TrevorKayongaJoel/AWS/CAD MODELS/prototype panel seperators/gateway acrilic.dxf

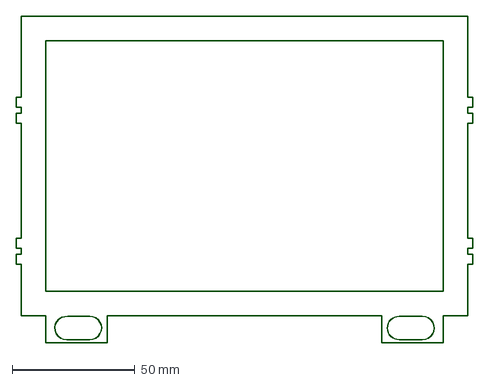
[picture p1: CAD file, 2026-03-18]
CAD MODELS/prototype panel seperators/gateway acrilic.dxf
186.0 x 133.0 mm
