TrevorKayongaJoel/AWS/CAD MODELS/prototype panel seperators/seperator.dxf

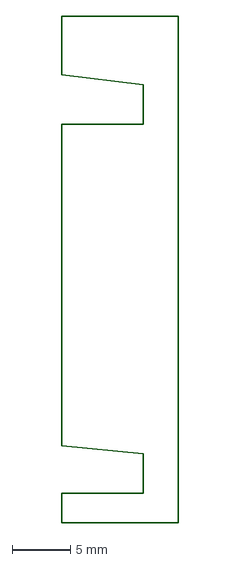
[picture p2: CAD file, 2026-03-18]
CAD MODELS/prototype panel seperators/seperator.dxf
10.0 x 43.4 mm
