TrevorKayongaJoel/AWS/CAD MODELS/prototype panel seperators/power acrilic.dxf

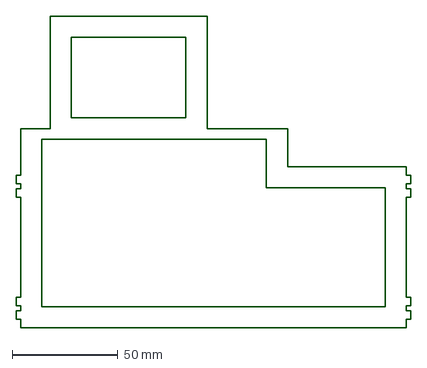
[picture p3: CAD file, 2026-03-18]
CAD MODELS/prototype panel seperators/power acrilic.dxf
186.0 x 147.0 mm
