TrevorKayongaJoel/AWS/(list of files, cad)

Other CAD files:
CAD MODELS/prototype panel seperators/seperator AWS.dwg
