TrevorKayongaJoel/AWS/CAD MODELS/prototype panel seperators/seperator AWS-Layout1.pdf

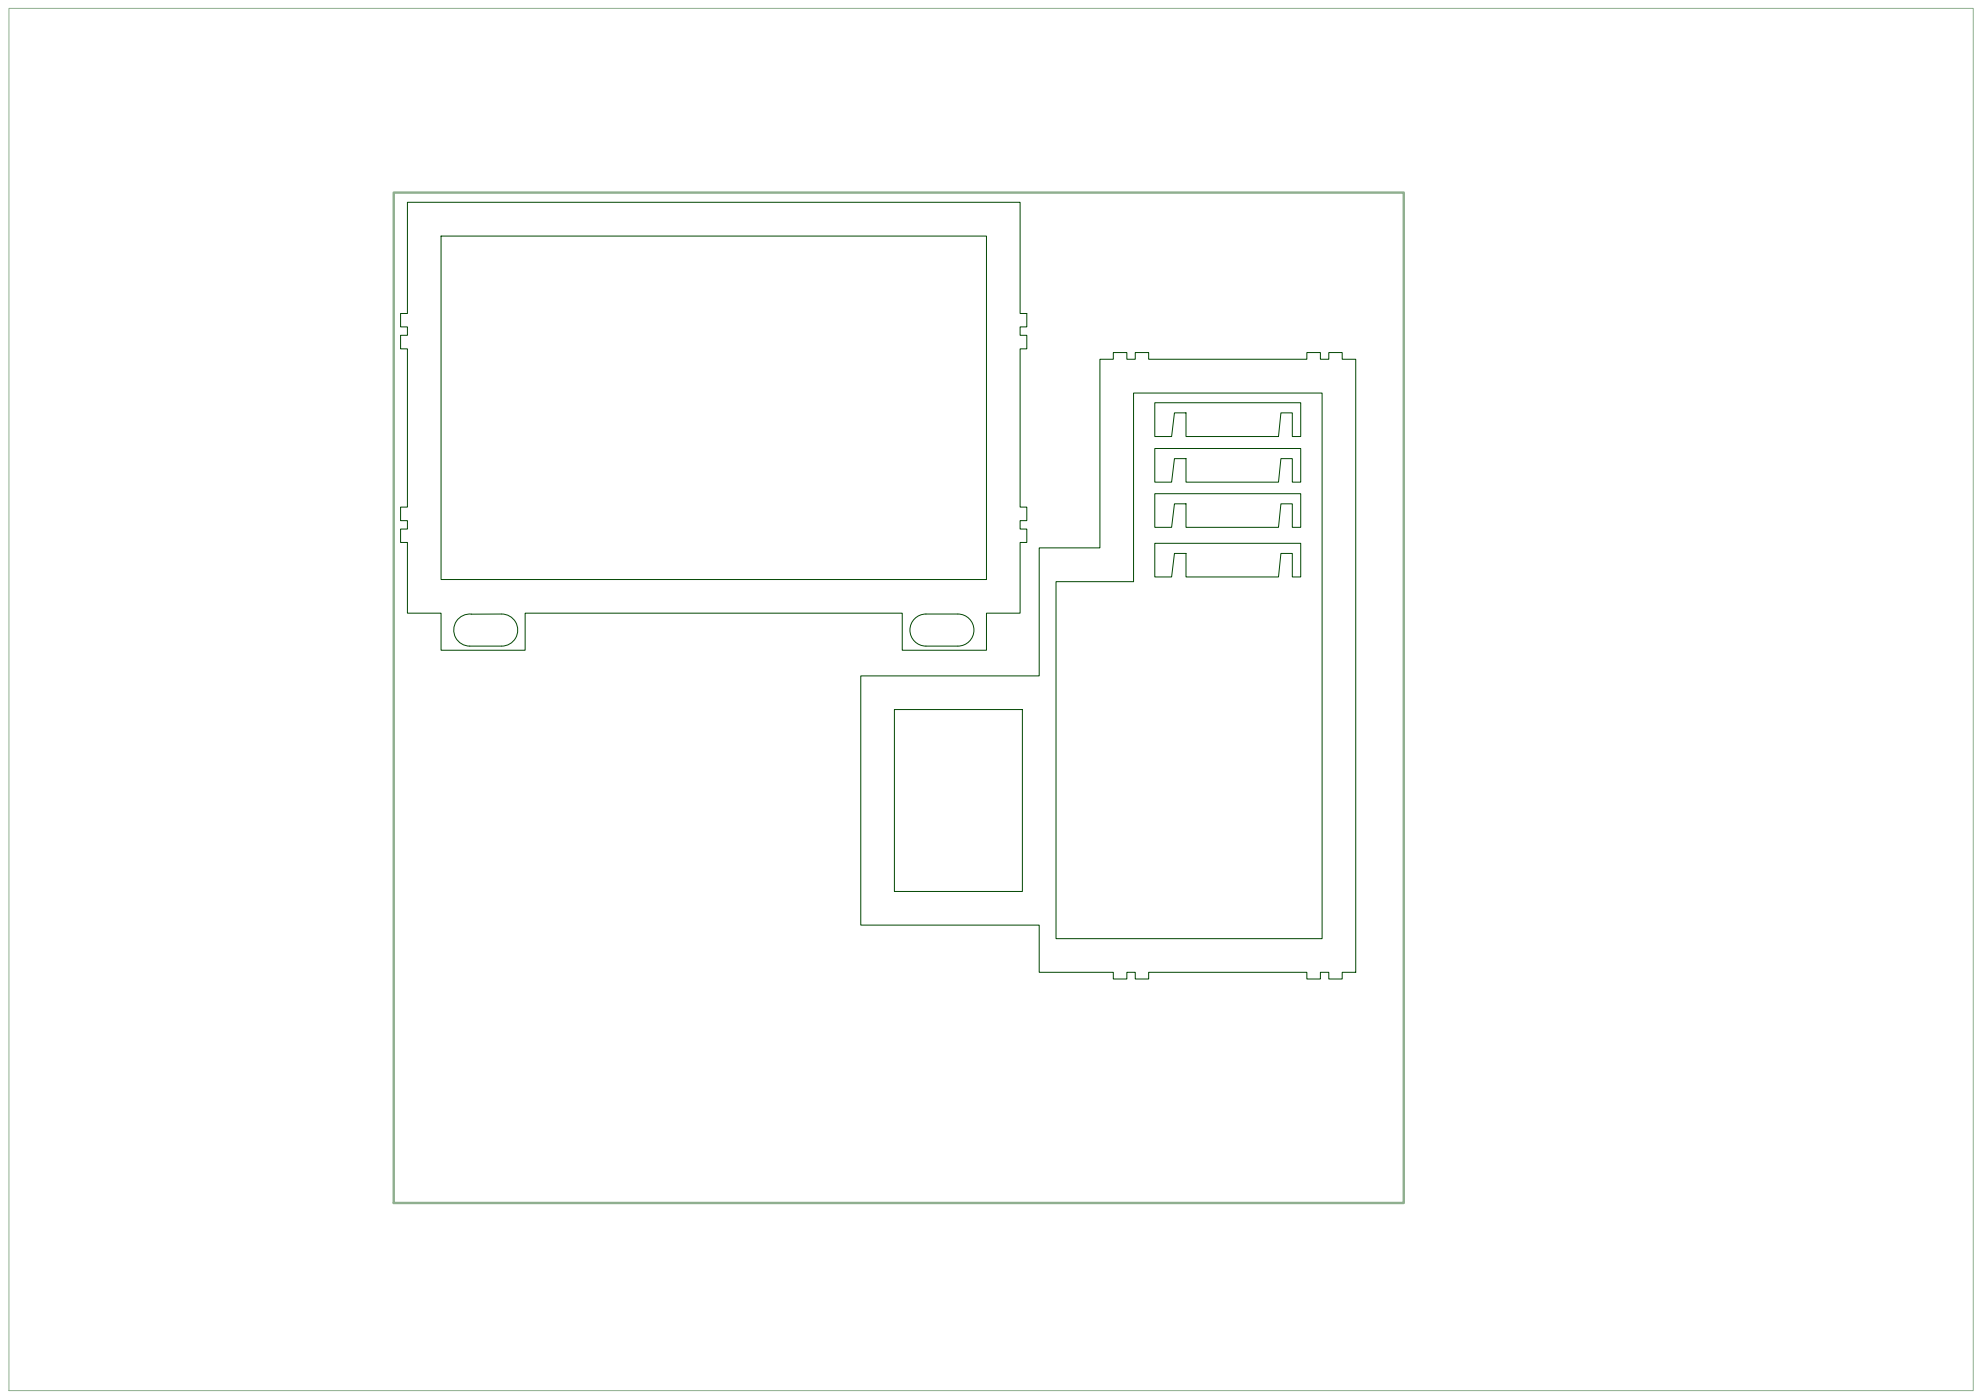
[picture p4: page 1]
