TrevorKayongaJoel/AWS/KiCAD FILES/power.kicad_sch

## KiCad design KiCAD FILES/power.kicad_sch (2026-03-18)

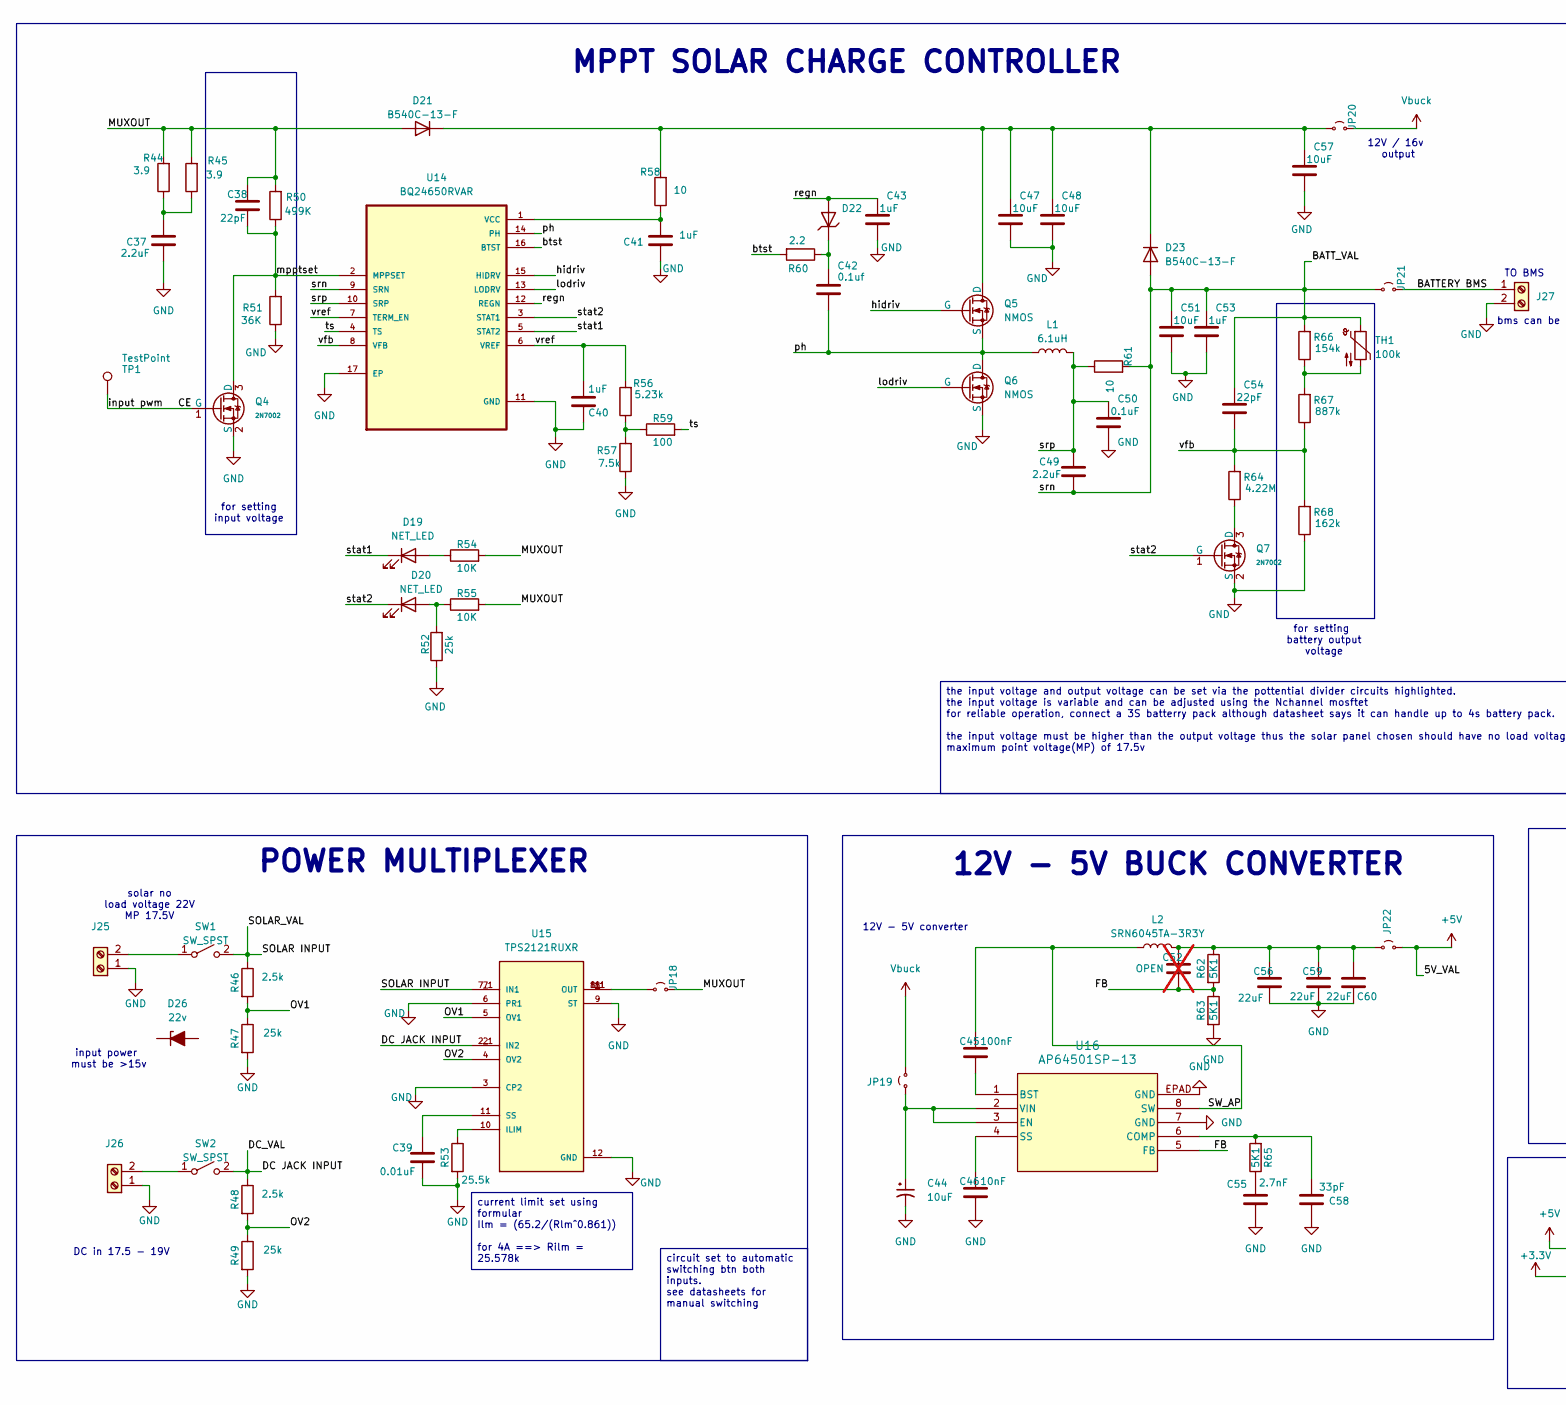
[picture p5: schematic power.kicad_sch, part in row 1, column 1]

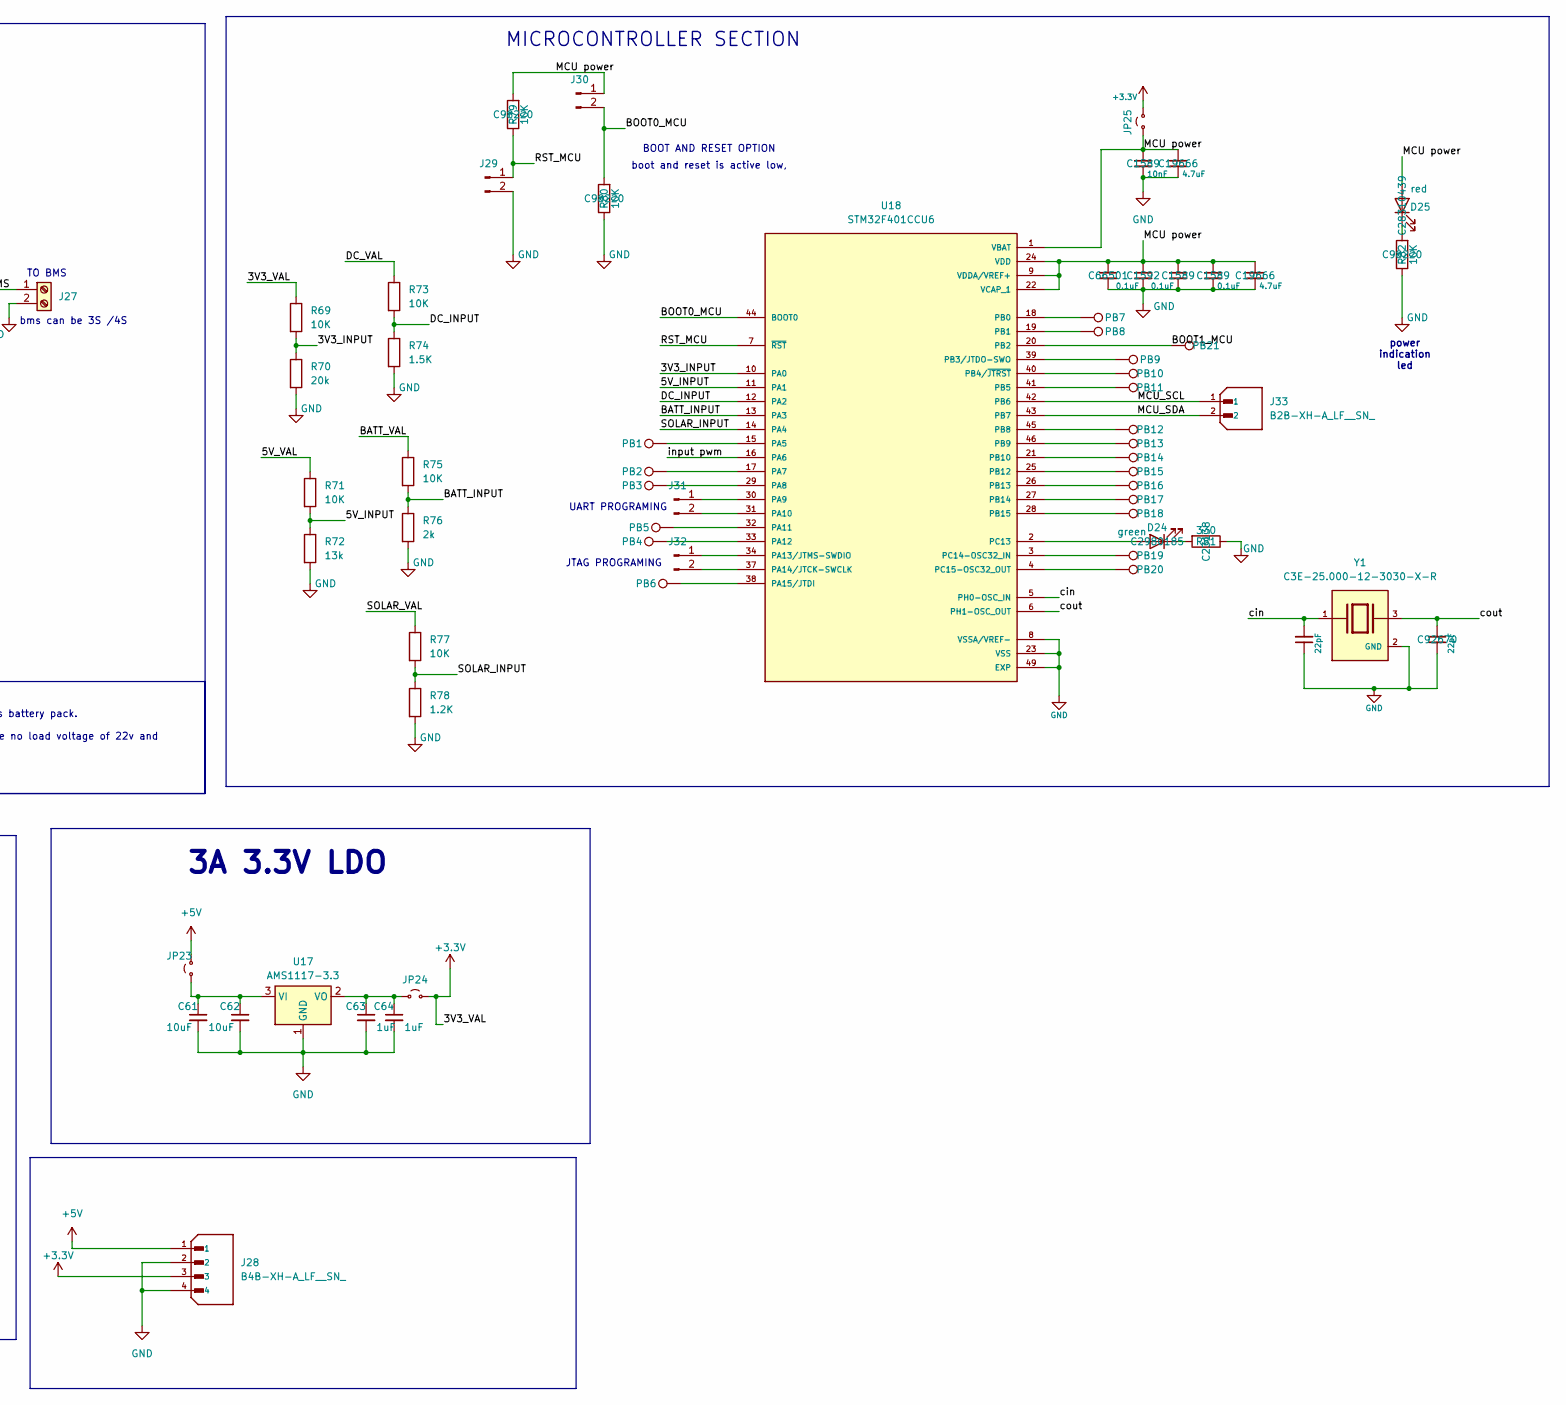
[picture p6: schematic power.kicad_sch, part in row 1, column 2]

Parts:
C37, C49: 2.2uF; C_0603_1608Metric_Pad1.08x0.95mm_HandSolder; DigiKey_Part_Number CC0603KRX7R9BB103
C38, C54: 22pF; C_0603_1608Metric_Pad1.08x0.95mm_HandSolder; DigiKey_Part_Number CC0603KRX7R9BB103
C39: 0.01uF; C_0603_1608Metric_Pad1.08x0.95mm_HandSolder; DigiKey_Part_Number CC0603KRX7R9BB103
C40, C41, C43, C53: 1uF; C_0603_1608Metric_Pad1.08x0.95mm_HandSolder; DigiKey_Part_Number CC0603KRX7R9BB103
C42: 0.1uf; C_0603_1608Metric_Pad1.08x0.95mm_HandSolder; DigiKey_Part_Number CC0603KRX7R9BB103
C44: 10uF; CP_Elec_5x5.8; LCSC C30110
C45: 100nF; C_1206_3216Metric_Pad1.33x1.80mm_HandSolder; LCSC C24497
C46: 10nF; C_0603_1608Metric_Pad1.08x0.95mm_HandSolder; DigiKey_Part_Number CC0603KRX7R9BB103
C47, C48: 10uF; C_1206_3216Metric_Pad1.33x1.80mm_HandSolder; DigiKey_Part_Number CC0603KRX7R9BB103
C50: 0.1uF; C_0603_1608Metric_Pad1.08x0.95mm_HandSolder; DigiKey_Part_Number CC0603KRX7R9BB103
C51: 10uF; C_0603_1608Metric_Pad1.08x0.95mm_HandSolder; DigiKey_Part_Number CC0603KRX7R9BB103
C52: OPEN; C_0603_1608Metric_Pad1.08x0.95mm_HandSolder; not fitted
C55: 2.7nF; C_0603_1608Metric; DigiKey_Part_Number 0603B272K500NT
C56, C59, C60: 22uF; C_0603_1608Metric_Pad1.08x0.95mm_HandSolder; DigiKey_Part_Number CL10A226MO7JZNC
C57: 10uF; C_1210_3225Metric_Pad1.33x2.70mm_HandSolder; DigiKey_Part_Number CC0603KRX7R9BB103
C58: 33pF; C_0603_1608Metric; DigiKey_Part_Number CC0603JRNPO9BN330
C61, C62: 10uF; C_0603_1608Metric; LCSC C19702
C63, C64: 1uF; C_0603_1608Metric; LCSC C15849
C65: 0.1uF; C_0603_1608Metric; LCSC C66501
C66: 10nF; C_0603_1608Metric; LCSC C1589
C67: 0.1uF; C_0603_1608Metric; LCSC C1592
C68, C71: 4.7uF; C_0603_1608Metric; LCSC C19666
C69, C70: 0.1uF; C_0603_1608Metric; LCSC C1589
C72, C73: 22pF; C_0603_1608Metric; LCSC C92670
D19, D20: NET_LED; D_0603_1608Metric; LCSC C22371297
D21, D23: B540C-13-F; D_SMB-SMC_Universal_Handsoldering; LCSC C72264
D22: PESDHC3D3V3U; D_SOD-323F; Breakdown Voltage 12.3V; Part SMAJ10A; LCSC C41376407
D24: green; LED_1206_3216Metric; LCSC C2980185
D25: red; LED_1206_3216Metric; LCSC C28310439
D26: 22v
J25, J26, J27: Screw_Terminal_01x02; TerminalBlock_MetzConnect_Type011_RT05502HBWC_1x02_P5.00mm_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
J28: B4B-XH-A_LF__SN_; JST_B4B-XH-A_LF__SN_; PARTREV 7/4/21
J29, J30, J31, J32: Conn_01x02_Pin; PinHeader_1x02_P2.54mm_Vertical
J33: B2B-XH-A_LF__SN_; JST_B2B-XH-A_LF__SN_; PARTREV N/A
JP18, JP19, JP20, JP22, JP23, JP24, JP25: Jumper_2_Small_Open; SolderJumper-2_P1.3mm_Open_RoundedPad1.0x1.5mm
JP21: Jumper_2_Small_Open; SolderJumper-2_P1.3mm_Open_Pad1.0x1.5mm
L1: 6.1uH; CDEP147NP-6R1MC-95; LCSC C2454102
L2: SRN6045TA-3R3Y; L_Bourns_SRN6045TA; LCSC C3221229
PB1, PB2, PB3, PB4, PB5, PB6, PB7, PB8, PB9, PB10, PB11, PB12, PB13, PB14, PB15, PB16, PB17, PB18, PB19, PB20, PB21: TestPoint; TestPoint_Pad_D1.0mm
Q4, Q7: 2N7002; Q_SOT-23; Part 2N7002; LCSC C8545
Q5, Q6: NMOS; TRANS_NVMFS5834NLWFT1G; LCSC C604579
R44, R45: 3.9; R_0603_1608Metric; LCSC C2930150
R46, R48: 2.5k; R_0603_1608Metric_Pad0.98x0.95mm_HandSolder; LCSC C22912
R47, R49: 25k; R_0603_1608Metric_Pad0.98x0.95mm_HandSolder; LCSC C2828621
R50: 499K; R_0603_1608Metric; LCSC C26751
R51: 36K; R_0603_1608Metric; LCSC C2930097
R52: 25k; R_0603_1608Metric; LCSC C2828637
R53: 25.5k; R_0603_1608Metric_Pad0.98x0.95mm_HandSolder; LCSC C2933234
R54, R55, R69, R71, R73, R75, R77, R79, R80, R82: 10K; R_0603_1608Metric; LCSC C98220
R56: 5.23k; R_0603_1608Metric; LCSC C2930111
R57: 7.5k; R_0603_1608Metric; LCSC C2930127
R58: 10; R_0603_1608Metric; LCSC C109318
R59: 100; R_0603_1608Metric; LCSC C105588
R60: 2.2; R_0603_1608Metric; LCSC C22939
R61: 10; R_1812_4532Metric; LCSC C2933875
R62, R63, R65: 5K1; R_0603_1608Metric_Pad0.98x0.95mm_HandSolder; LCSC C2907044
R64: 4.22M; R_0603_1608Metric; LCSC C3009313
R66: 154k; R_0603_1608Metric; LCSC C861677
R67: 887k; R_0603_1608Metric; LCSC C5126163
R68: 162k; R_0603_1608Metric; LCSC C2998114
R70: 20k; R_0603_1608Metric; LCSC C105575
R72: 13k; R_0603_1608Metric; LCSC C2906992
R74: 1.5K; R_0603_1608Metric; LCSC C22843
R76: 2k; R_0603_1608Metric; LCSC C22975
R78: 1.2K; R_0603_1608Metric; LCSC C2906976
R81: 330; R_0603_1608Metric; LCSC C23138
SW1, SW2: SW_SPST; SW_DIP_SPSTx01_Slide_9.78x4.72mm_W7.62mm_P2.54mm
TH1: 100k; R_1812_4532Metric; LCSC C5146262
TP1: TestPoint; TestPoint_Pad_1.0x1.0mm
U14: BQ24650RVAR; QFN50P350X350X100-17N; LCSC C53712
U15: TPS2121RUXR; IC_TPS2121RUXR; DigiKey_Part_Number 296-53410-1-ND
U16: AP64501SP-13; SOIC127P600X170-9N; LCSC C2071517
U17: AMS1117-3.3; SOT-223-3_TabPin2; LCSC C6186
U18: STM32F401CCU6; QFN50P700X700X60-49N; PARTREV 11; LCSC C79861
Y1: C3E-25.000-12-3030-X-R; XTAL_C3E-25.000-12-3030-X-R; PARTREV August 01, 2022; LCSC C5567192

Connections:
3V3_INPUT: R69.2, R70.1, U18.10 (PA0)
5V_INPUT: R71.2, R72.1, U18.11 (PA1)
+3.3V: J28.3, JP24.2 (B), JP25.2 (B), R69.1
+5V: J28.1, JP22.2 (B), JP23.2 (B), R71.1
BATTERY BMS: J27.1, JP21.2 (B)
BATT_INPUT: R75.2, R76.1, U18.13 (PA3)
BATT_VAL: C49.2, C51.1, C53.1, C54.1, D23.2 (A), JP21.1 (A), R61.2, R66.2, R75.1, TH1.1, U14.9 (SRN)
BOOT0_MCU: J30.2, R80.2, U18.44 (BOOT0)
BOOT1_MCU: PB21.1, U18.20 (PB2)
CE: Q4.1 (G), TP1.1, U18.16 (PA6)
DC JACK INPUT: R48.1, R73.1, SW2.2 (B), U15.2 (IN2), U15.2_1 (IN2)
DC_INPUT: R73.2, R74.1, U18.12 (PA2)
FB: C52.2, R62.2, R63.1, U16.5 (FB)
GND: C37.2, C39.2, C40.2, C41.2, C43.2, C44.2, C46.2, C47.2, C48.2, C50.2, C51.2, C53.2, C55.2, C56.2, C57.2, C58.2, C59.2, C60.2, C61.2, C62.2, C63.2, C64.2, C65.2, C66.2, C67.2, C68.2, C69.2, C70.2, C71.2, C72.1, C73.1, J25.1, J26.1, J27.2, J28.2, J28.4, J29.2, Q4.2 (S), Q6.1 (S), Q6.2 (S), Q6.3 (S), Q7.2 (S), R47.2, R49.2, R51.1, R52.1, R53.2, R57.1, R63.2, R68.1, R70.2, R72.2, R74.2, R76.2, R78.2, R80.1, R81.1, R82.1, U14.11 (GND), U14.17 (EP), U15.3 (CP2), U15.6 (PR1), U15.9 (ST), U15.12 (GND), U16.7 (GND), U16.EPAD (GND), U17.1 (GND), U18.8 (VSSA/VREF-), U18.23 (VSS), U18.35 (VSS), U18.47 (VSS), U18.49 (EXP), Y1.2 (GND), Y1.4 (GND)
MCU power: C65.1, C66.1, C67.1, C68.1, C69.1, C70.1, C71.1, D25.2 (A), J30.1, JP25.1 (A), R79.2, U18.1 (VBAT), U18.9 (VDDA/VREF+), U18.22 (VCAP_1), U18.24 (VDD), U18.36 (VDD), U18.48 (VDD)
MCU_SCL: J33.1, U18.42 (PB6)
MCU_SDA: J33.2, U18.43 (PB7)
MUXOUT: C38.1, D21.2 (A), JP18.2 (B), R44.2, R45.2, R50.2, R54.2, R55.2
unnamed: C37.1, R44.1, R45.1
unnamed: C39.1, U15.11 (SS)
unnamed: C41.1, R58.1, U14.1 (VCC)
unnamed: C42.1, D22.1, R60.1
unnamed: C44.1, JP19.1 (A), U16.2 (VIN), U16.3 (EN)
unnamed: C45.2, U16.1 (BST)
unnamed: C46.1, U16.4 (SS)
unnamed: C47.1, C48.1, C57.1, D21.1 (K), D23.1 (K), JP20.1 (A), Q5.5_6 (D), R58.2
unnamed: C52.1, C56.1, C59.1, C60.1, JP22.1 (A), L2.2, R62.1
unnamed: C55.1, R65.1
unnamed: C58.1, R65.2, U16.6 (COMP)
unnamed: C61.1, C62.1, JP23.1 (A), U17.3 (VI)
unnamed: C63.1, C64.1, JP24.1 (A), U17.2 (VO)
unnamed: D19.2 (A), R54.1
unnamed: D20.2 (A), R52.2, R55.1
unnamed: D24.1 (K), R81.2
unnamed: D24.2 (A), U18.2 (PC13)
unnamed: D25.1 (K), R82.2
unnamed: J25.2, SW1.1 (A)
unnamed: J26.2, SW2.1 (A)
unnamed: J31.1, U18.30 (PA9)
unnamed: J31.2, U18.31 (PA10)
unnamed: J32.1, U18.34 (PA13/JTMS-SWDIO)
unnamed: J32.2, U18.37 (PA14/JTCK-SWCLK)
unnamed: JP18.1 (A), U15.1 (OUT), U15.1_1 (OUT), U15.8 (OUT), U15.8_1 (OUT)
unnamed: PB1.1, U18.15 (PA5)
unnamed: PB2.1, U18.17 (PA7)
unnamed: PB3.1, U18.29 (PA8)
unnamed: PB4.1, U18.33 (PA12)
unnamed: PB5.1, U18.32 (PA11)
unnamed: PB6.1, U18.38 (PA15/JTDI)
unnamed: PB7.1, U18.18 (PB0)
unnamed: PB8.1, U18.19 (PB1)
unnamed: PB9.1, U18.39 (PB3/JTDO-SWO)
unnamed: PB10.1, U18.40 (PB4/~JTRST)
unnamed: PB11.1, U18.41 (PB5)
unnamed: PB12.1, U18.45 (PB8)
unnamed: PB13.1, U18.46 (PB9)
unnamed: PB14.1, U18.21 (PB10)
unnamed: PB15.1, U18.25 (PB12)
unnamed: PB16.1, U18.26 (PB13)
unnamed: PB17.1, U18.27 (PB14)
unnamed: PB18.1, U18.28 (PB15)
unnamed: PB19.1, U18.3 (PC14-OSC32_IN)
unnamed: PB20.1, U18.4 (PC15-OSC32_OUT)
unnamed: Q7.3 (D), R64.1
unnamed: R53.1, U15.10 (ILIM)
unnamed: R56.1, R57.2, R59.1
unnamed: R66.1, R67.2, TH1.2
OV1: R46.2, R47.1, U15.5 (OV1)
OV2: R48.2, R49.1, U15.4 (OV2)
RST_MCU: J29.1, R79.1, U18.7 (~RST)
SOLAR INPUT: R46.1, R77.1, SW1.2 (B), U15.7 (IN1), U15.7_1 (IN1)
SOLAR_INPUT: R77.2, R78.1, U18.14 (PA4)
SW_AP: C45.1, L2.1, U16.8 (SW)
Vbuck: JP19.2 (B), JP20.2 (B)
btst: R60.2, U14.16 (BTST)
cin: C72.2, U18.5 (PH0-OSC_IN), Y1.1
cout: C73.2, U18.6 (PH1-OSC_OUT), Y1.3
hidriv: Q5.4 (G), U14.15 (HIDRV)
lodriv: Q6.4 (G), U14.13 (LODRV)
mpptset: C38.2, Q4.3 (D), R50.1, R51.2, U14.2 (MPPSET)
ph: C42.2, L1.1, Q5.1 (S), Q5.2 (S), Q5.3 (S), Q6.5_6 (D), U14.14 (PH)
regn: C43.1, D22.2, U14.12 (REGN)
srp: C49.1, C50.1, L1.2, R61.1, U14.10 (SRP)
stat1: D19.1 (K), U14.5 (STAT2)
stat2: D20.1 (K), Q7.1 (G), U14.3 (STAT1)
ts: R59.2, U14.4 (TS)
vfb: C54.2, R64.2, R67.1, R68.2, U14.8 (VFB)
vref: C40.1, R56.2, U14.6 (VREF), U14.7 (TERM_EN)

Notes on the sheet:
boot and reset is active low,
power indication led
for setting battery output voltage
12V / 16v output
UART PROGRAMING
MPPT SOLAR CHARGE CONTROLLER
JTAG PROGRAMING
POWER MULTIPLEXER
input power must be >15v
MICROCONTROLLER SECTION
BOOT AND RESET OPTION
3A 3.3V LDO
bms can be 3S /4S
12V - 5V BUCK CONVERTER
TO BMS
DC in 17.5 - 19V
solar no load voltage 22V MP 17.5V
for setting input voltage
12V - 5V converter
current limit set using formular Ilm = (65.2/(Rlm^0.861)) for 4A ==> Rilm = 25.578k
circuit set to automatic switching btn both inputs. see datasheets for manual switching
the input voltage and output voltage can be set via the pottential divider circuits highlighted. the input voltage is variable and can be adjusted using the Nchannel mosftet for reliable operation, connect a 3S batterry pack although datasheet says it can handle up to 4s battery pack. the input vol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
