TrevorKayongaJoel/AWS/PROJECT CODE/src/DHT22.cpp

#include <Arduino.h>
#include "DHT22.h"
#include <Adafruit_Sensor.h>
#include <DHT.h>
#include <DHT_U.h>
#include <string>
using namespace std;

#define DHTTYPE    DHT22     // DHT 22 (AM2302)
DHT_Unified dht(DHTPIN, DHTTYPE);
uint32_t delayMS;


DHTSensor::DHTSensor() : pin_(DHTPIN), temperature_(0.0), humidity_(0.0) {
    // Initialize the sensor (if needed)
}

void DHTSensor::getsensor() {
    // Serial.begin(9600); // REMOVED: Serial already initialized in main.cpp
    
    dht.begin();
  
  // Print temperature sensor details.
  sensor_t sensor;
  dht.temperature().getSensor(&sensor);
  Serial.println(F("------------------------------------"));
  Serial.println(F("Temperature Sensor"));
  Serial.print  (F("Sensor Type: ")); Serial.println(sensor.name);
  Serial.print  (F("Driver Ver:  ")); Serial.println(sensor.version);
  Serial.print  (F("Unique ID:   ")); Serial.println(sensor.sensor_id);
  Serial.print  (F("Max Value:   ")); Serial.print(sensor.max_value); Serial.println(F("°C"));
  Serial.print  (F("Min Value:   ")); Serial.print(sensor.min_value); Serial.println(F("°C"));
  Serial.print  (F("Resolution:  ")); Serial.print(sensor.resolution); Serial.println(F("°C"));
  Serial.println(F("------------------------------------"));
  // Print humidity sensor details.
  dht.humidity().getSensor(&sensor);
  Serial.println(F("Humidity Sensor"));
  Serial.print  (F("Sensor Type: ")); Serial.println(sensor.name);
  Serial.print  (F("Driver Ver:  ")); Serial.println(sensor.version);
  Serial.print  (F("Unique ID:   ")); Serial.println(sensor.sensor_id);
  Serial.print  (F("Max Value:   ")); Serial.print(sensor.max_value); Serial.println(F("%"));
  Serial.print  (F("Min Value:   ")); Serial.print(sensor.min_value); Serial.println(F("%"));
  Serial.print  (F("Resolution:  ")); Serial.print(sensor.resolution); Serial.println(F("%"));
  Serial.println(F("------------------------------------"));
  // Set delay between sensor readings based on sensor details.
  delayMS = sensor.min_delay / 2000;
}

float DHTSensor::readTemperature() {
    // Get temperature event and print its value.
  sensors_event_t event;
  dht.temperature().getEvent(&event);
  if (isnan(event.temperature)) {
    Serial.println(F("Error reading temperature!"));
  }
  else {
    Serial.print(F("Temperature: "));
    Serial.print(event.temperature);
    Serial.println(F("°C"));
  }

    temperature_ = event.temperature;
    delay(delayMS);
    return temperature_;
}

float DHTSensor::readHumidity() {
    // Get humidity event and print its value.
  sensors_event_t event;
  dht.humidity().getEvent(&event);
  if (isnan(event.relative_humidity)) {
    Serial.println(F("Error reading humidity!"));
  }
  else {
    Serial.print(F("Humidity: "));
    Serial.print(event.relative_humidity);
    Serial.println(F("%"));
  }

    humidity_ = event.relative_humidity;
    delay(delayMS);
    return humidity_;
}
