TrevorKayongaJoel/AWS/(commit log)

2026-03-18 updates to design files, made prototype models
    [gateway acrilic.dxf, power acrilic.dxf, power.kicad_sch, seperator AWS.dwg, seperator.dxf]
2026-04-27 Commit current project changes
2026-05-14 10Min Fixed duty cycling
    [main.cpp]
